doboszm/greenhouseBoard/Report.pdf

# DESIGN OF AN AUTONOMOUS GREENHOUSE

Group 6

March 21, 2021

Design of an Autonomous Greenhouse | Team G06

## Contents

1 Control Interface | 5

2

## List of Figures

1 | Microcontroller schematic | | 5
2 | SPI/ISP resistor connections | | 6
3 | 4 layer PCB stackup | | 7
4 | Differential transmission line | | 7
5 | Microcontroller peripherals schematic | | 8
6 | RDS vs VGS | | 9
7 | Sensors schematic | | 10
8 | LDR voltage divider schematic | | 11
9 | Microcontroller power system schematic | | 12
10 | Capacitor impedance curve | | 13
11 | Oscilloscope ground spring | | 14
12 | D3V3 ripple and A3V3 ripple | | 15
13 | Fuse status indicator simulation | | 16
14 | IPC-2221 curves | | 17
15 | Control PCB | | 18

3

## List of Tables

1 | PMV16XN specs | | 8
2 | DS1307 real time clock specs | | 9
3 | BME280 temperature/humidity sensor specs | | 10
4 | SEN-13322 soil moisture sensor specs | | 11
5 | GL5516 light dependant resistor specs | | 11
6 | SM8102 and LP3219 specs | | 12
7 | Voltage regulator resistor specs | | 14
8 | Voltage regulator output measurements | | 14
9 | Surface mount equivalent of through hole components used in simulation | | 16
10 | Microcontroller peripheral current draws | | 16

4

## 1 Control Interface

### 1.1 Control PCB

The entire greenhouse system is controlled by a custom designed PCB based on the ATmega32u4 microcon-toller from Microchip.

### 1.1.1 Controller Design

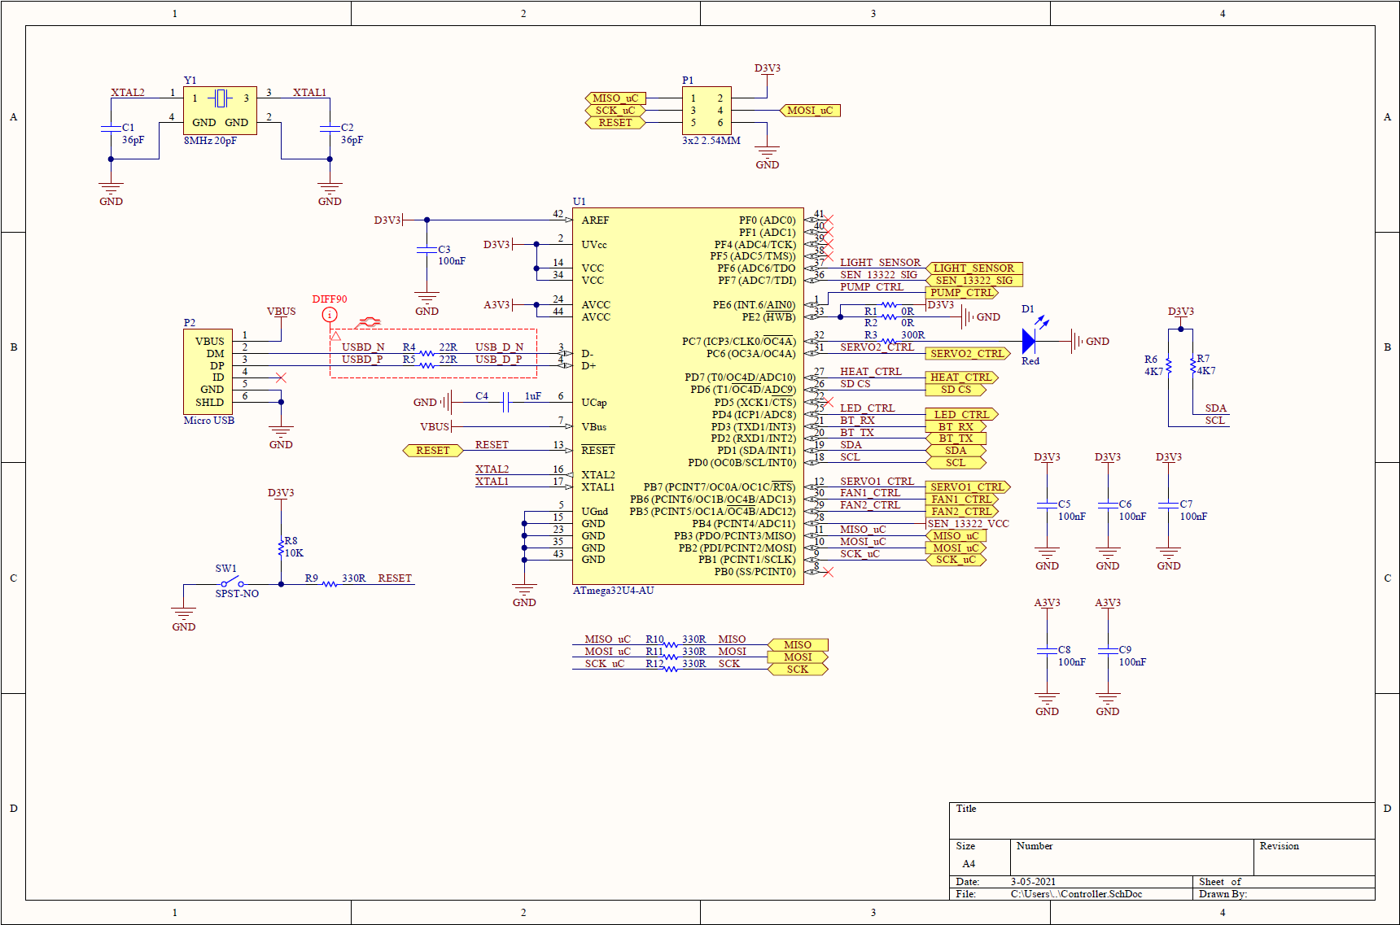
[picture p1: figure]

Figure 1: Controller

U1 represents the ATmega32u4 microcontroller. The ATmega32u4 is an 8-bit AVR RISC based microcontroller with 32KB of flash memory, 2.5KB of SRAM and 1KB EEPROM. This controller was selected due to its ease of programming (Arduino IDE support), package (QFP-44) and native USB support.

P1 represents the ISP programmer header which is used to burn the bootloader and set the fuse bits on the microcontroller to allow it to be programmed directly through USB and to set the clock frequency. This interface utilizes a modified SPI bus (RESET replaces chip select).

Y1 represents the system clock crystal. Due to selecting to power the microcontroller off 3.3V instead of 5V, the microcontroller must be run at 8MHz instead of 16MHz. This is sufficient for this application as there are no fast ADC reads being done or time specific image processing. A crystal with 20pF load capacitance was selected as this is the most common value found on the market. To calculate the load capacitors (C1 and C2), the following formula was used

5

Cload =

C

2
x
2Cx
+ Cstray | (1)

Cload = 20pF (from datasheet)
Cstray = 2pF (safe assumption if traces are short)
Solving for Cx in (1) gives Cx = 36pF

As stated in AVR042 [1], if additional devices are connected to the SPI bus when the ISP lines are connected, 330R series resistors must be placed on the bus as shown below. Since the SD card uses the SPI bus to interface with the microcontroller, the series resistors were added to prevent driving the SD card from the ISP programmer.

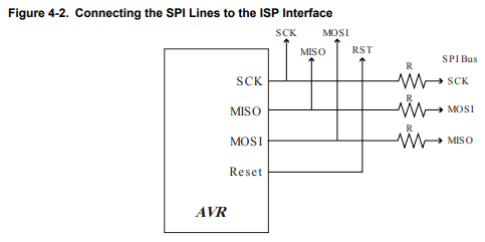
[picture p2: figure]

Figure 2: SPI/ISP resistor connections

In order to achieve the required differential impedance of 90Ω ± 10% on the USB differential pairs (labeled DIFF90), the following formula is used to solve for w, the trace width

Zd =

174
√
r + 1.41

ln
5.98 × h
0.8 × w + t

1 − 0.48 exp
−0.96

d
h
| (2)

Where
Zd = target differential impedance, 90Ω ± 10% (81Ω − 99Ω) t = layer thickness, 1.378 mils
h = dielectric thickness, 7.874 mils
d = trace separation, 5 mils
r = relative dielectric constant, 4.6
These values were obtained from the board stackup presented below

6

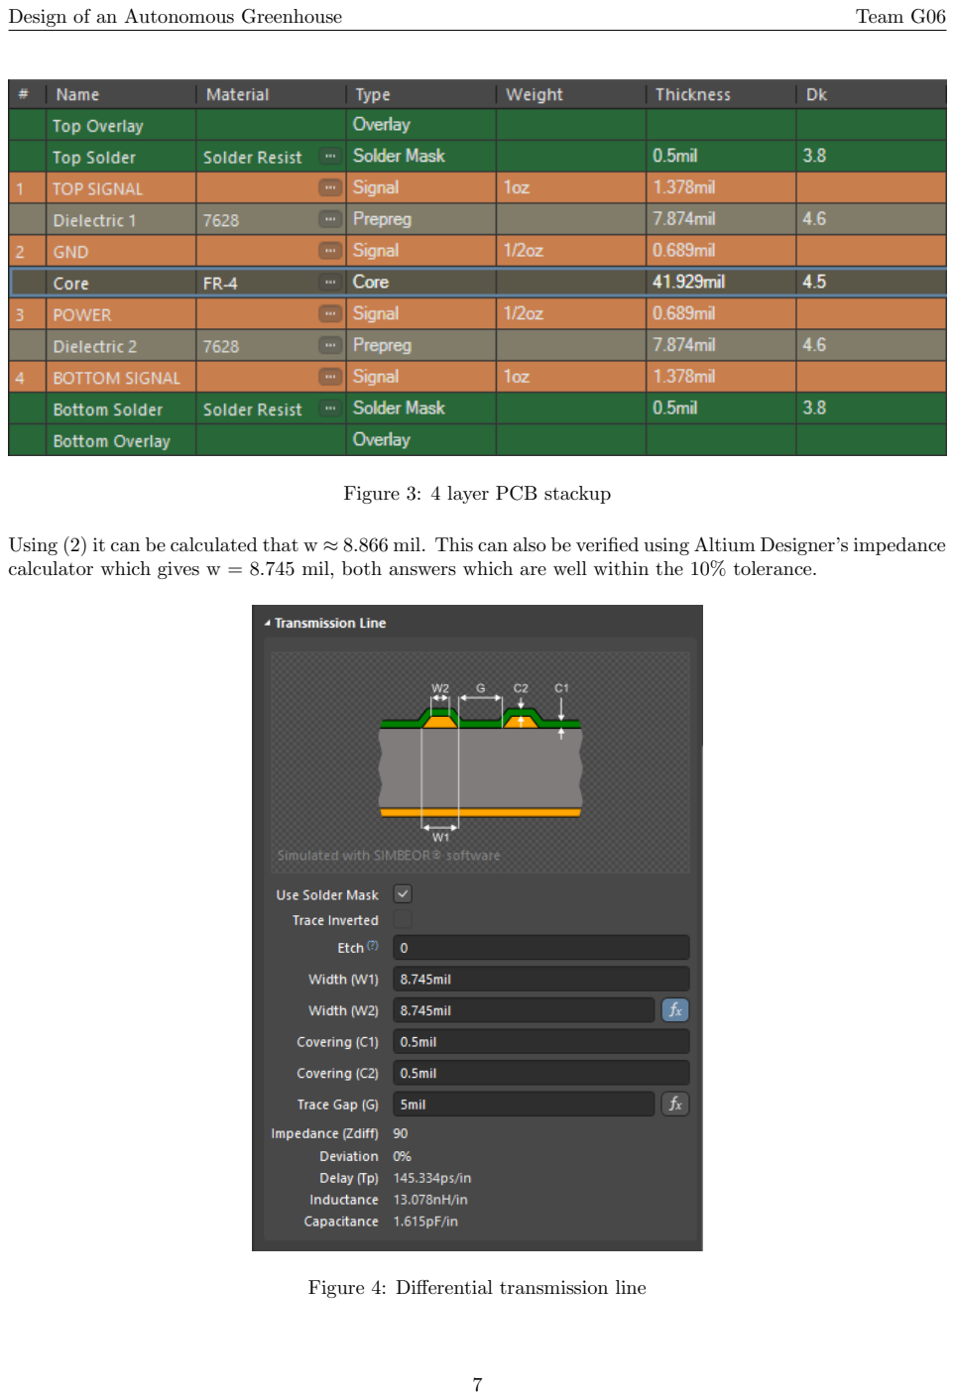
[picture p3: page 7]

Figure 3: 4 layer PCB stackup

Using (2) it can be calculated that w ≈ 8.866 mil. This can also be verified using Altium Designer’s impedance calculator which gives w = 8.745 mil, both answers which are well within the 10% tolerance.

Figure 4: Differential transmission line

7

Assuming the following
Etch factor = 0, making W1 = W2 = W Solder mask thickness (C1, C2) = 0.5 mils Trace gap (G) = 5 mils
Gives a width (W) = 8.745 mils

### 1.1.2 Peripheral Design

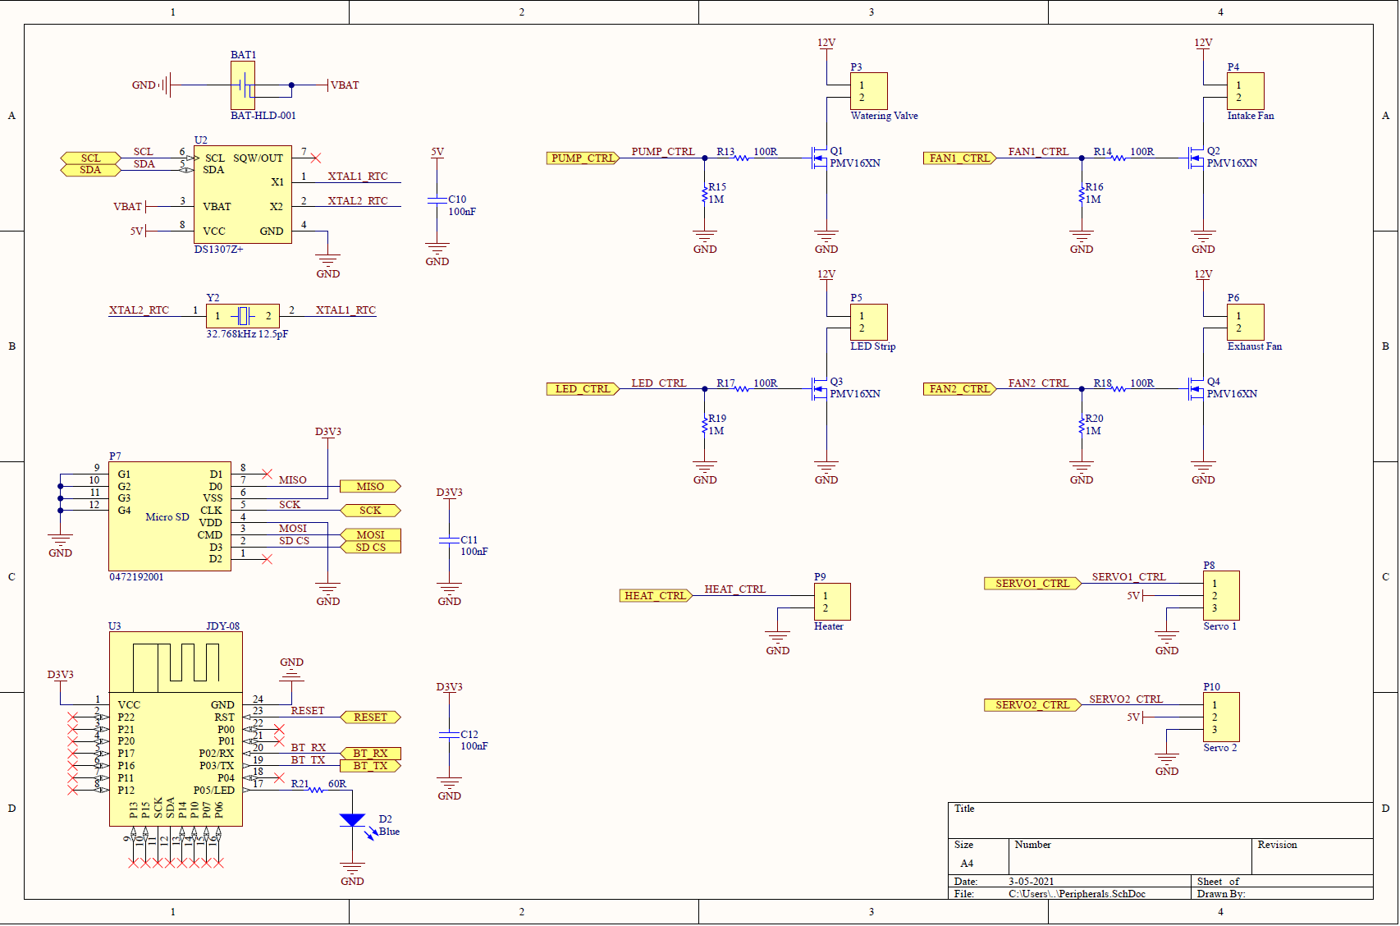
[picture p4: figure]

Figure 5: Peripherals

Each microcontroller pin can only sink up to 40mA, so in order to be able to drive the LED strip (P5), fans (P4 and P6) and valve (P3), a MOSFET driver is required. The MOSFET that was selected was the PMV16XN.

ID (max) | 8.6A
VGS | ±12V
VDS | 20V

Table 1: PMV16XN specs [2]

8

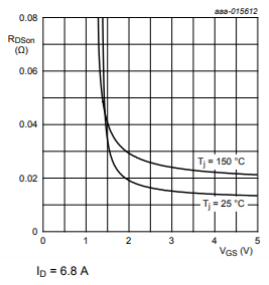
[picture p5: figure]

Figure 6: RDS vs VGS [2]

The PMV16XN was selected due to it having a VGS of ±12 V, which means that the MOSFET can be controlled with 3.3V and having a VDS of 20V means a 12V load can be driven with no problem. Looking at Figure 6 above, it can be seen that at a VGS of 3.3V, RDSon ≈ 15mΩ. This means at ID = 8.6A, the MOSFET will produce 1.11W of heat, no heatsink required. A 1MΩ pulldown resistor was added so that the output would not be floating in the even that the microcontroller pins are in high impedance mode.

The DS1307 real time clock (U2) is used to keep accurate time for data logging even when the PCB is not powered (from external CR2032 battery). The DS1307 supply must be 5V, however 3.3V falls in the logic high range for the device. This means that the DS1307 can be interfaced by a 3.3V microcontroller while still being powered by 5V (this is important as in this application the ATmega32u4 is running at 3.3V). The DS1307 also draws 1.5mA when active. This is the worst case, however it can be assumed that it constantly draws 1.5mA for power draw calculations.

I 2C Address | 0x68
VCC | 4.5 to 5.5V
Logic 1 Input (VIH) | 2.2 to (VDD + 0.3)V
Logic 0 Input (VIL) | -0.3 to 0.8V
Standby Current | 200µA (when SDA, SCL = 5V)
Active Current | 1.5mA

Table 2: DS1307 real time clock specs [3]

The JDY-08 Bluetooth module (U3) is used to send data wirelessly though Bluetooth to the Raspberry Pi. For interfacing, this particular module can use software UART, i.e. any digital pins can be used and not just the RX/TX pins (RX is connected to PB5 and TX is connected to PB6). The blue LED (D2) on P05 lights up solid when a Bluetooth connection is established.

The portable car heater (connected to P9) that is used to heat up the greenhouse is controlled by a solid

9

state relay, which is able to drive a 25A, 12V load directly from the microcontroller pin. In testing, it was measured that the input current to the solid state relay was 2mA at 3.1V.

The servos (connected to P8 and P10) are used to control the intake and exhaust fan flaps. The angle of rotation on the servo is controlled by a PWM wave from the microcontroller which is then decoded by the servo’s control circuitry.

### 1.1.3 Sensor Design

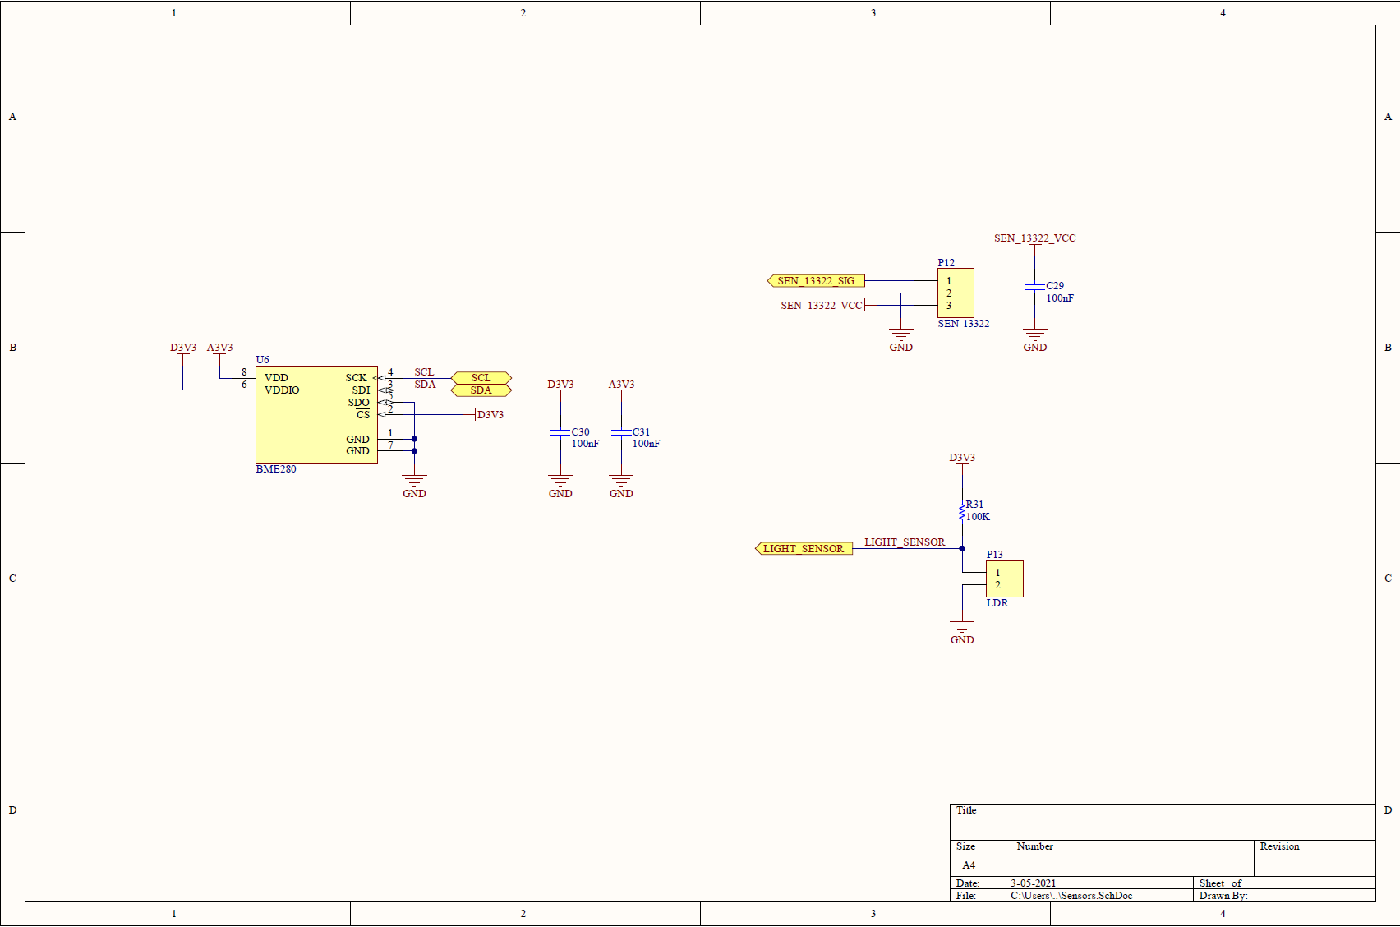
[picture p6: figure]

Figure 7: Sensors

The BME280 (U6) can be run at 1.8V or 3.3V (for this application it is run at 3.3V). This sensor requires the analog supply voltage ripple (VDD) to be under 50mVpp. The BME280 also requires I²C pullup resistors on both the SDA and SCL lines. The value was selected as 4K7 as this meets the requirements for I²C pullups for both the BME280 and DS1307.

2C Address I | 0x76 or 0x77
VDD (A3V3) | 1.71 to 3.6V (50mVpp ripple max)
VDDIO (D3V3) | 1.2 to 3.6V
Standby Current | 0.5 µA
Humidity Measurement Current | 340µA
Temperature Measurement Current | 350µA
Pressure Measurement Current | 714µA

Table 3: BME280 temperature/humidity sensor specs [4]

10

The SEN-13322 soil moisture sensor (connected to P12) has 3 pins for interfacing: VCC, GND and SIG. The sensor’s SIG pin connects to any microcontroller ADC pin. It is recommended by the manufacturer to only power the device when reading, and since the current draw of the device is only 0.33mA, it can be safely driven from a microcontroller pin.

VCC | 3.3 to 5.0V
Active Current | 0.33mA (3.3V /10kΩ = 0.33mA)

Table 4: SEN-13322 soil moisture sensor specs

The GL5516 LDR (connected to P13) is used to measure the light level. Since it is difficult to calibrate a light dependent resistor without a luxmeter, the ADC value is simply read at pitch black and direct sunlight and a linear equation is fit to the two data points. This is sufficient enough to detect when the sun is out or not (take measurement at sunset/sunrise and set as threshold). To calculate the ADC values that are read by the microcontroller, consider the following voltage divider circuit

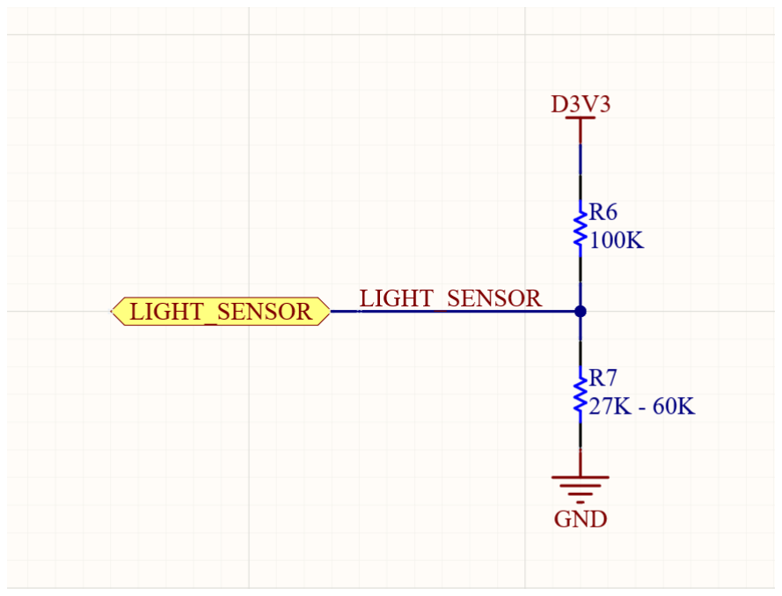
[picture p7: figure]

Figure 8: LDR voltage divider

Using the following formula

VOUT = VS

R7
R6 + R7
(3)

And plugging in VS = 3.3V , R6 = 100K and R7 = 27K to 60K gives a voltage range of 0.702 to 1.238 V. That voltage range is then read as a 10 bit value (0-1023) and internally converted back to a voltage for easier programming using the following formula

Vactual =

ADCReading ∗ 3.3V
1024

(4)

VCC | 150V MAX
Resistance range | 27k to 60kΩ
Current draw (Ohm’s Law, 100kΩ in series with LDR) | 0.02 to 0.03mA

Table 5: GL5516 light dependant resistor specs [5]

11

### 1.1.4 Power System Design

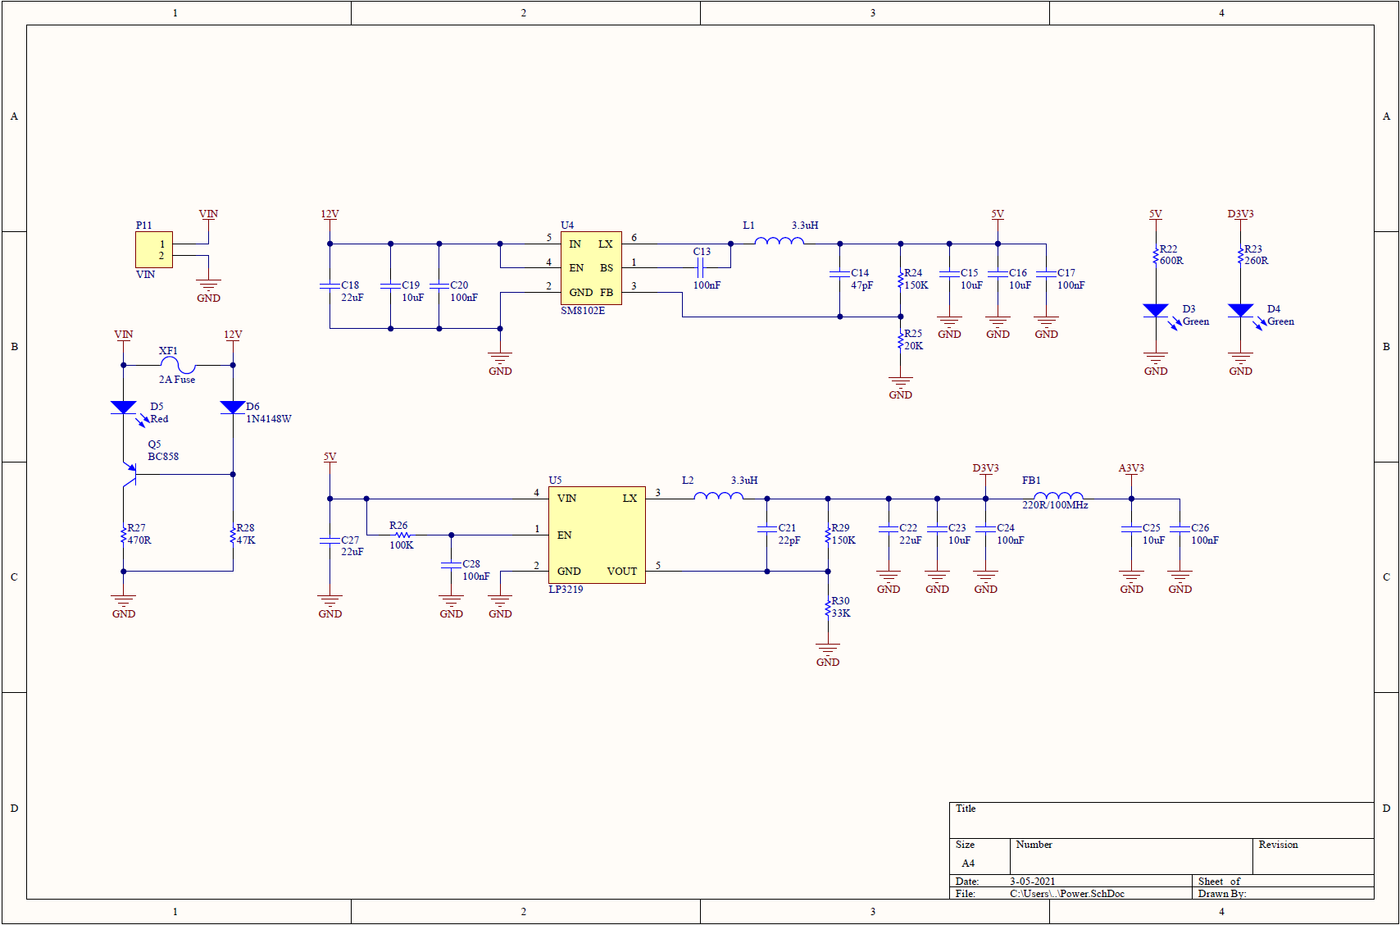
[picture p8: figure]

Figure 9: Power system

The board receives 12V (VIN) from the car battery, which is then fed into two step down regulators (12V-5V, 5V-3.3V).

SM8102 | | LP3219
Input Voltage Range | 4.2V-18V | Input Voltage Range | 2.5V-5.5V
Max Output Current | 2A | Max Output Current | 2A
Switching Frequency | 500kHz | Switching Frequency | 1.5MHz

Table 6: SM8102 [6] and LP3219 [7] specs

These regulators were selected due to them meeting the power requirements (input voltage and output current) and their high efficiency (due to them being switching power supplies as opposed to low dropout regulators). The bypass/decoupling capacitors (C18, C19, C20, ...) placed on the input and output of each regulator stabilize the voltages and reduce ripple. As every electrical engineer knows, the current through a capacitor is given by

i(t) = C

dV
dt | (5)

Since an instantaneous change in voltage would cause dV
dt to be very large, in order for (5) to hold, i(tx) would have to be equally as large, which is not possible in practice. This property allows capacitors to be used to smooth power supplies and to supply steady voltage levels to digital circuits. The reason for different

12 values in parallel is that the impedance of a capacitor changes as the frequency changes. The impedance of a ”real” capacitor can be represented as

ZC = XC + XL + ESR | (6)

Where ESR is the equivalent series resistance, which come from the imperfections in the capacitor. Since the reactance of a capacitor and inductor are given by

XC =

1
jωC | (7)

and

XL = jωL | (8)

Substituting (7) and (8) into (6) it can be shown that

ZC =

1
jωC + jωL + ESR | (9)

If this function is graphed, something similar to the following is obtained

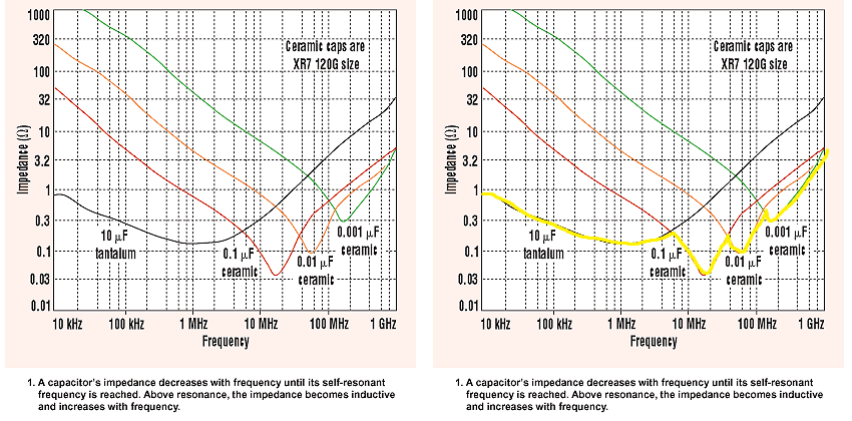
[picture p9: figure]

Figure 10: Capacitor impedance curve [8]

As ω increases, Xc decreases and XL increases. When Xc = XL (resonant frequency) the total impedance is the lowest. When multiple capacitors are placed in parallel, the curve becomes more like the yellow curve on the right. This gets more complicated when you factor in the composition (ceramic, tantalum, electrolytic) and size (0402, 0603, 0805) as these all play a role in equation (9), specifically the ESR component. The values of the capacitors in the design were selected for ideal performance by the manufacturer of the regulator chips.

To set the output voltage of U4 and U5, the resistors R24, R25, R29 and R30 are selected to set a specific voltage at the FB/VOUT pins. The required resistors for both regulators are calculated using the following formula
VOUT = 0.6(1 + RH
RL
) | (10)

13

This formula was used to calculate the following values

SM8102 | LP3219
RH | 150KΩ | RH | 150KΩ
RL | 20KΩ | RL | 33KΩ
VOUT | 5.1V | VOUT | 3.32V

Table 7: Voltage regulator resistors

The closest resistors that are available were selected that give a bit of overshoot on the output, as the output voltage will lower when loaded. Each voltage was measured with a multimeter at the appropriate output capacitor for 5V and 3.3V. The theoretical values were obtained from (10).

Theoretical Value | Measured Value | % Error
5.100V | 5.107V | 0.137
3.320V | 3.385V | 1.958

Table 8: Voltage regulator output measurements

The ferrite bead (FB1) separates the digital 3.3V supply from the analog 3.3V supply. While not completely necessary, adding a bead in series reduces the noise on the more sensitive analog supply as it acts as a second order filter along with the bypass capacitors. In order for the supply to function properly, the output voltage ripple must be measured on an oscilloscope and fall under 3% of the supply voltage, according to Microchip [9]. This is a general rule of thumb, however the BME280 datasheet specifies the 3.3V supplies are required to be under 50mVpp ripple due to the sensitive analog components. To measure the analog and digital 3.3V supplies (A3V3 and D3V3), a ground spring was connected to an oscilloscope probe to lower the ground loop size, ie. two ground points on the same circuit have different voltage potentials.

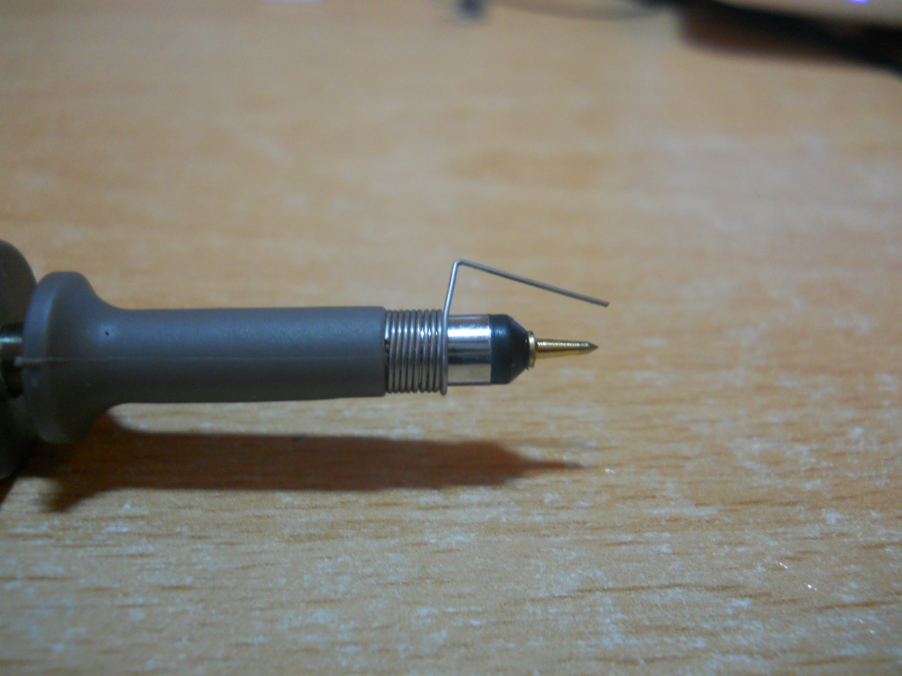
[picture p10: figure]

Figure 11: Oscilloscope ground spring

The probe was then used to measure the ripple on the output capacitors (C23 for D3V3, C25 for A3V3). The following waveforms were observed.

14

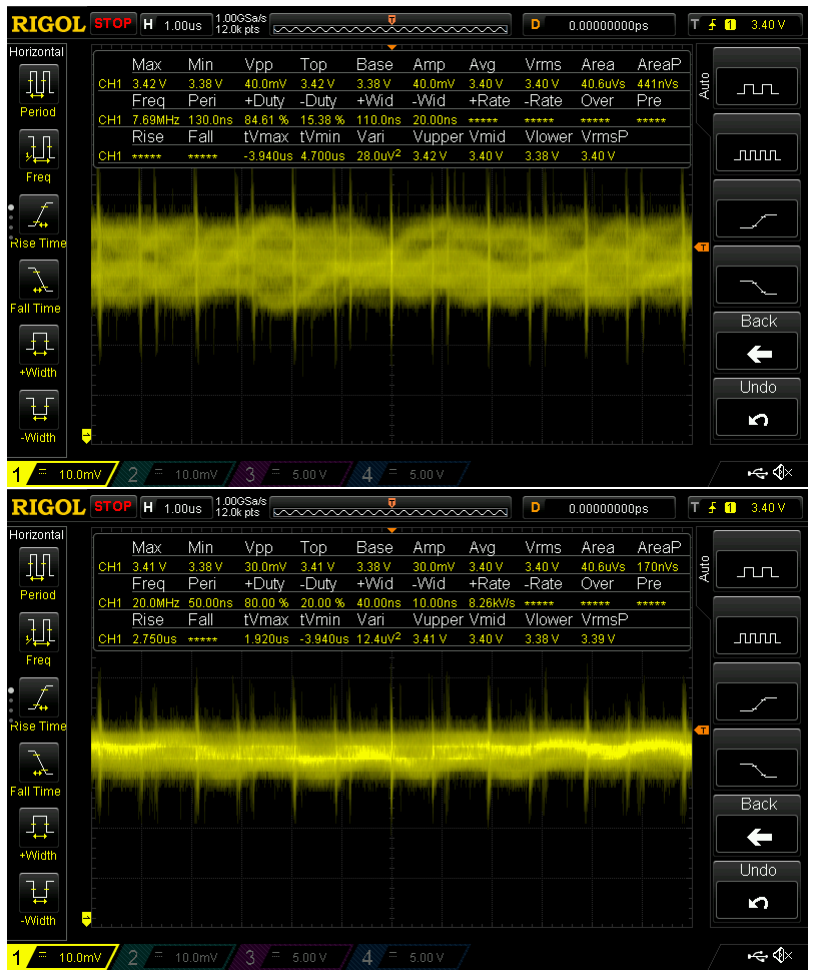
[picture p11: figure]

Figure 12: D3V3 ripple (top) and A3V3 ripple (bottom)

As can be seen, both waveforms are under the required 50mVpp (40mVpp for D3V3, 30mVpp for A3V3).

The power LEDs (D3, D4) require current limiting resistors. To calculate the required resistor value, the following formula is used

R =

Vs − Vf
If

(11)

Where
Vs = supply voltage (5V or 3.3V)
Vf = forward voltage (2V for green LED)
If = desired forward current (5mA)
Solving for R in each case gives R5V = 600R and R3.3V = 260R

The fuse indicator LED (D5) for the 2A ATO fuse is located between VIN and 12V. When the fuse is functional, the red LED will not light up and the circuit will operate as intended. When the fuse is blown, the red LED will light up. This can be seen in the following simulation results

15

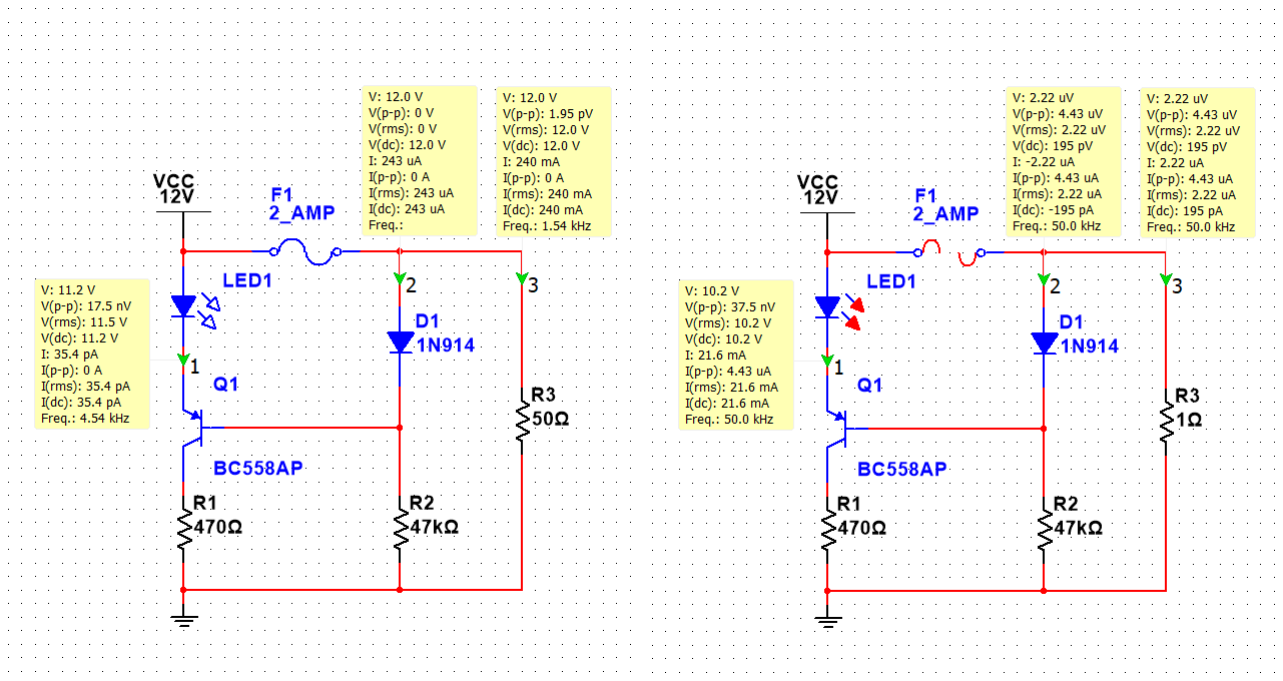
[picture p12: figure]

Figure 13: Fuse status indicator simulation

When a 50 ohm load is connected, a current of 240mA flows through the fuse. The current though the BJT and diode are extremely small (35.4pA and 243µA) and can be considered negligible. When a 1 ohm load is connected, a current of 12A flows through the fuse. This is more than enough to blow the fuse as seen in the right image. When the fuse is blown, the red LED illuminates. The active components used in the simulation are through hole components, however the following substitutions were made to allow all components to be SMD (substitutions have the same specs).

TH Component | SMD Equivalent | SMD Package
1N914 | 1N4148W | SOD-123
BC558 | BC858 | SOT-23

Table 9: Surface mount equivalent of through hole components used in simulation

To calculate the power trace thicknesses, the current draw of every peripheral was determined from the datasheets and are presented below

Peripheral | Voltage | Current Draw
Valve | 12V | 320mA
PC fans | 12V | 2x300mA = 600mA
LED strip | 12V | 850mA
Servos | 5V | 2x700mA = 1400mA
DS1307 | 5V | 1.5mA
Microcontroller, sensors, BT module, etc | 3.3V | <200mA

Table 10: Peripheral current draws

Using some approximations, it can be estimated that the 12V bus will draw around 3A (320mA + 600mA + 850mA + ∼500mA (for all 5V and 3.3V peripherals) ≈ 3A, allowing for some margin). The largest current draw on the 5V bus are the servos, which have a stall current of around 700mA each, depending on the

16 model. As an example, the trace width for 3A will be calculated. Using IPC-2221, the trace cross sectional area must first be calculated

A =

I
(k ∗ (Tr)

b)

1
c
(12)

Where
A = cross sectional area [mils² ]
I = current [A]
Tr = max temperature rise [◦C]
k = 0.024 (internal), 0.048 (external)
b = 0.44
c = 0.725
k, b, c are constants obtained from curve fitting the IPC-2221 curves [10]

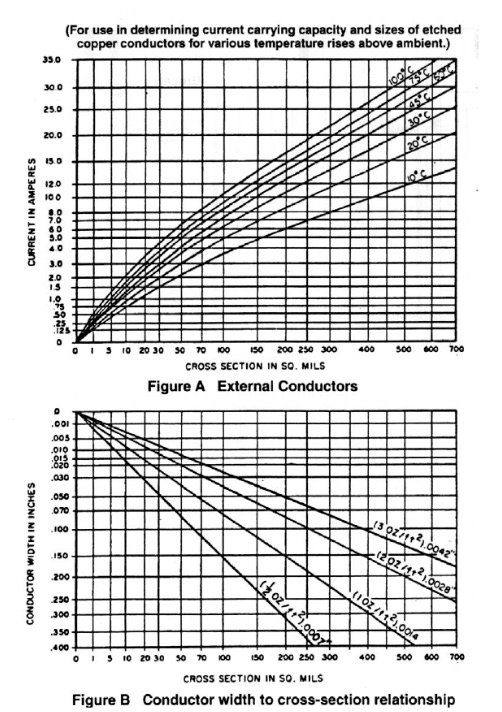
[picture p13: figure]

Figure 14: IPC-2221 curves [10]

17

With the values of Tr = 10◦C and I = 3A, it can be determined that A = 192.93 mils² for internal traces
and A = 74.16 mils²
for external traces are required. To calculate the width, the following formula is used

W =

A
T ∗ d

(13)

Where
W = trace width [mils]
A = cross sectional area [mils² ]
T = thickness [oz]
d = 1.378 mils/oz

A = 192.93 mils² and T = 0.5 oz results in W = 280 mils (internal traces)
A = 74.16 mils² and T = 1 oz results in W = 53.8 mils (external traces)

As it can be seen, 280 mils is very thick for a trace, so for the purposes of this PCB design a polygon pour was used for the high current traces. Using (12) and (13), it can be calculated that for a trace to be able to carry 500mA it must be at least 10 mils wide. This was used as the standard trace width for most signals. The final PCB can be seen below:

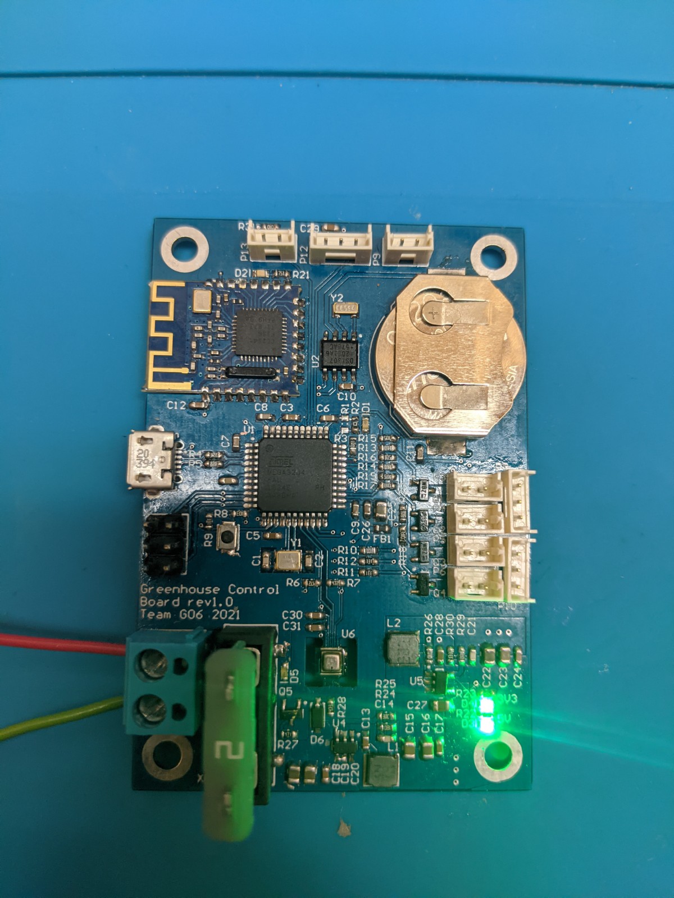
[picture p14: figure]

Figure 15: Control PCB

18
