doboszm/greenhouseBoard/Schematic.pdf

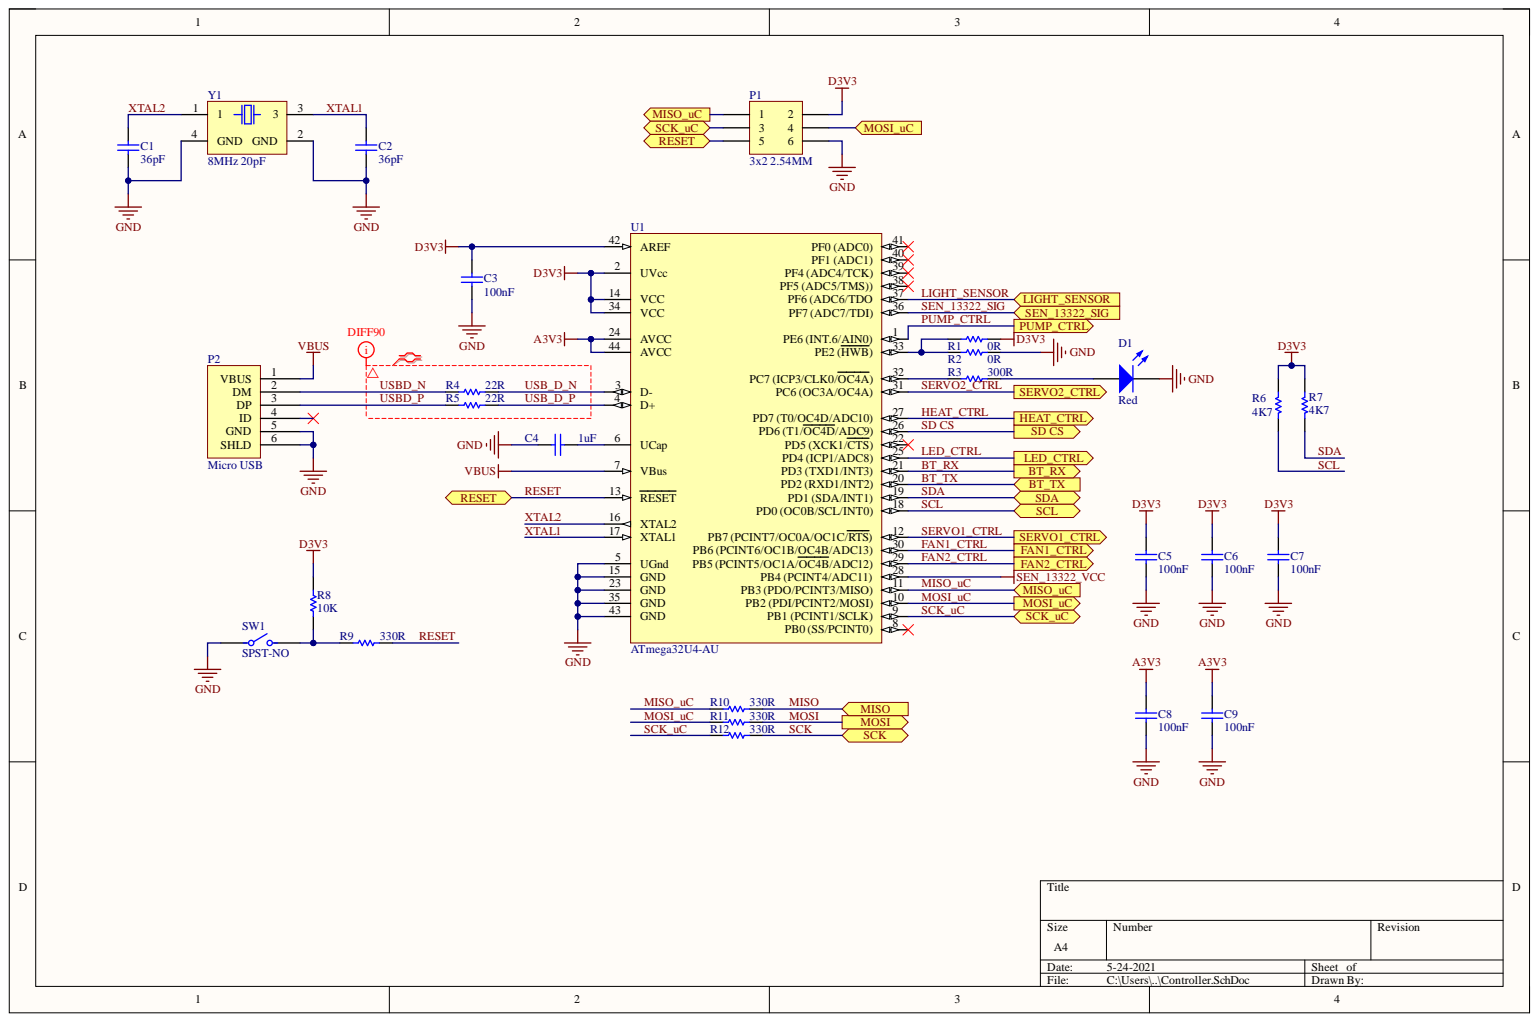
[picture p15: page 1]

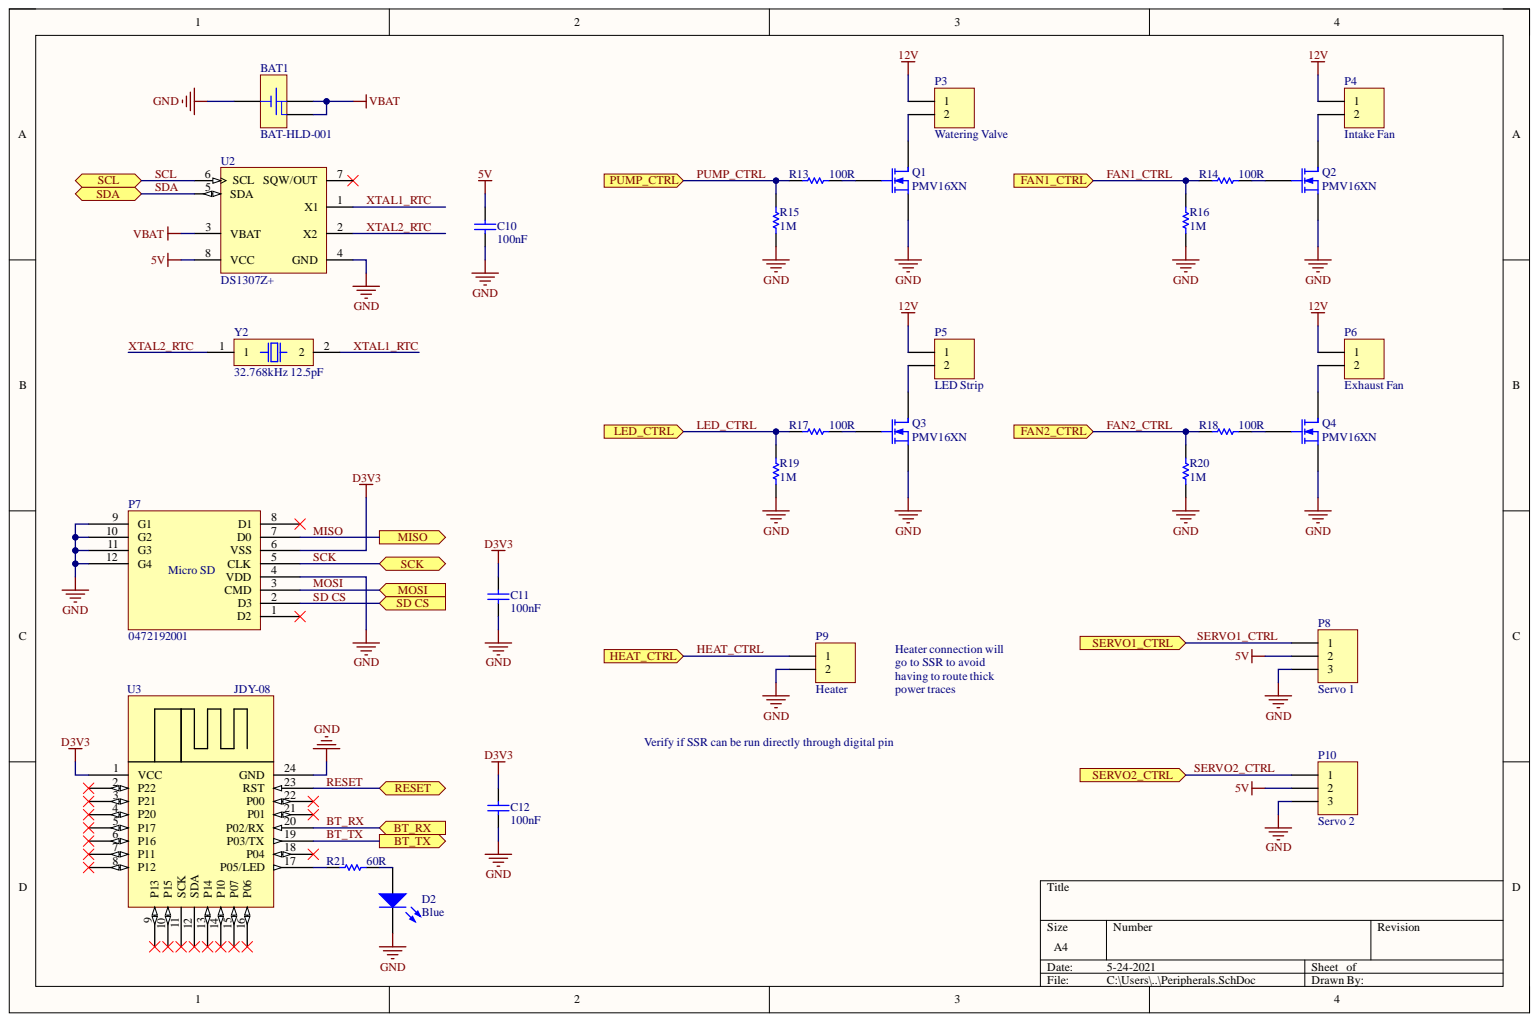
[picture p16: page 2]

G4 12 | SCK

MOSI SD CS

Heater connection will
go to SSR to avoid
having to route thick
power traces

Verify if SSR can be run directly through digital pin

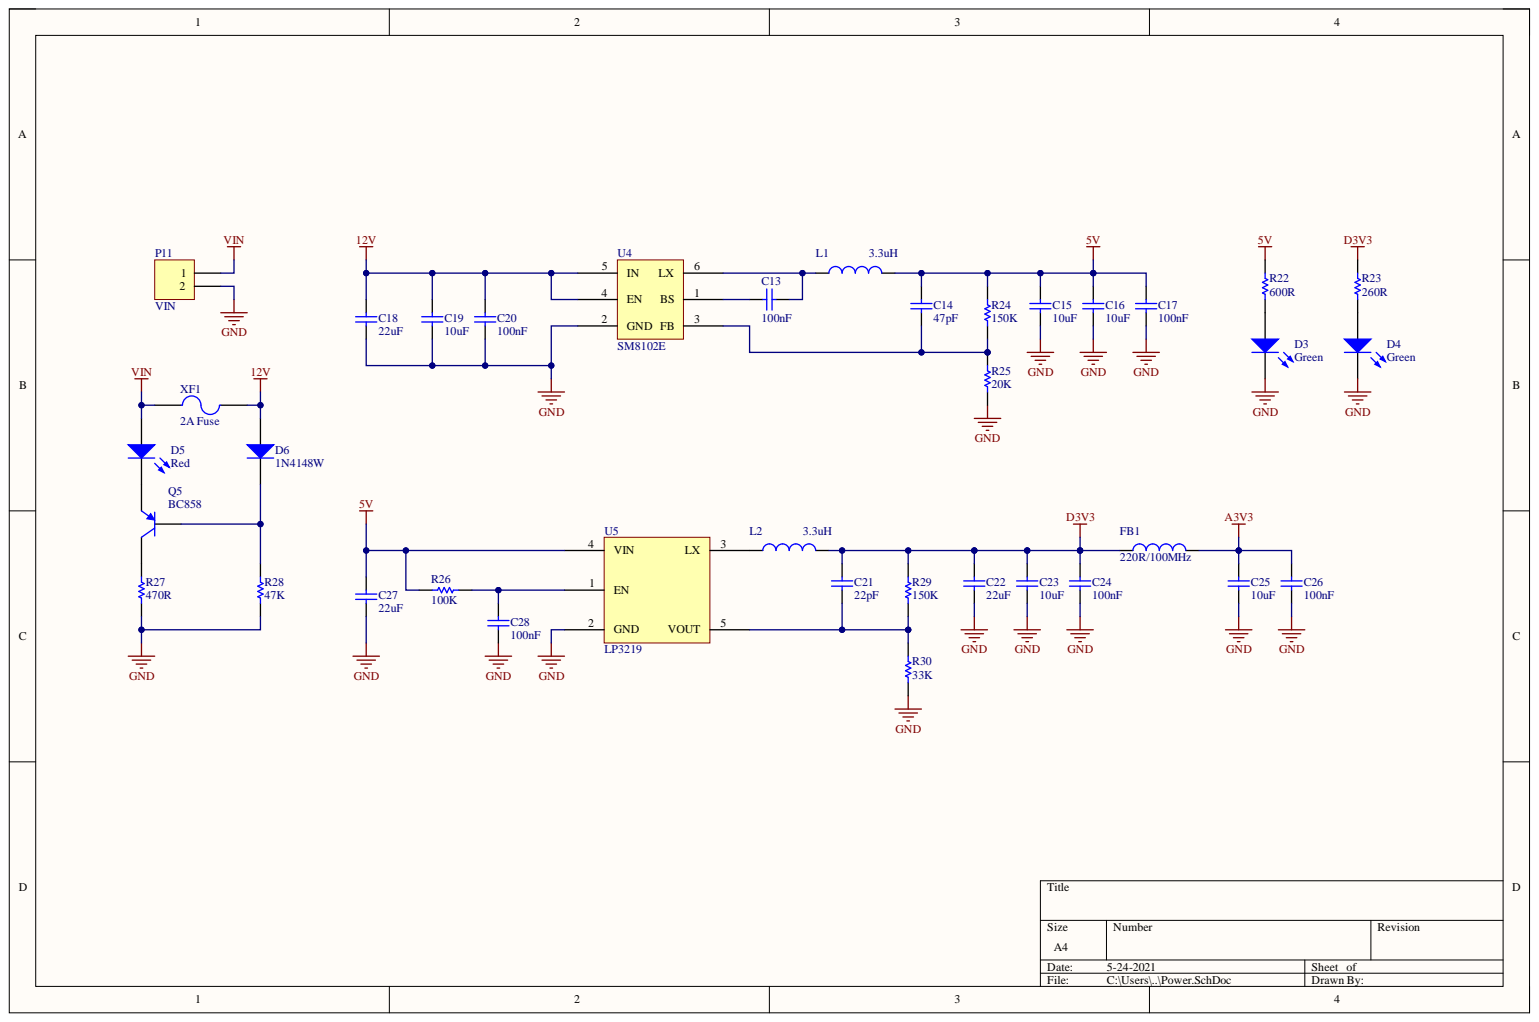
[picture p17: page 3]

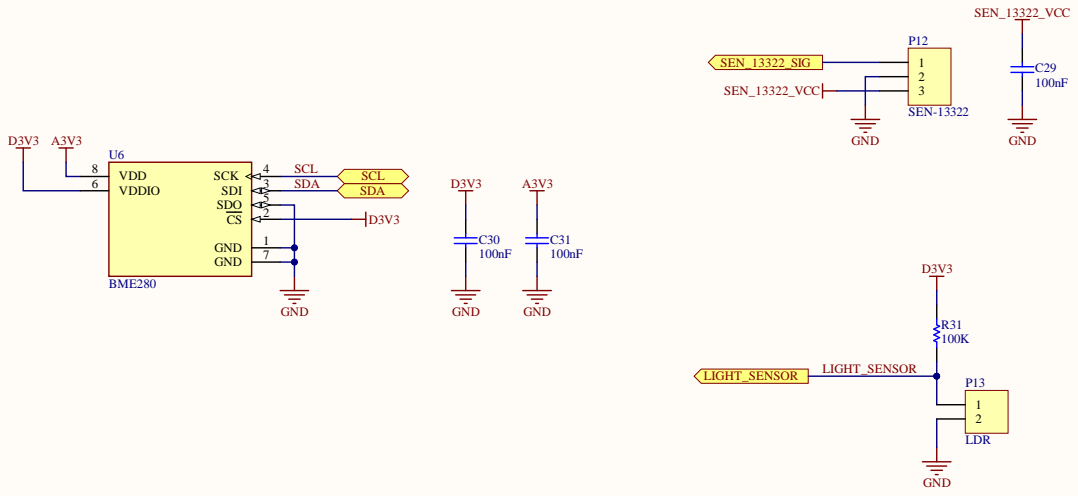
[picture p18: page 4]
