doboszm/greenhouseBoard/(list of files, drawings)

Other design files:
CAD files/Capstone Control Board.PcbDoc
CAD files/Capstone Control Board.PrjPcb
CAD files/Controller.SchDoc
CAD files/Peripherals.SchDoc
CAD files/Power.SchDoc
CAD files/Sensors.SchDoc
